mwelling/lofive/fab/lofive.xls

Qty | Reference(s) | Value | Footprint | Mfg. Part #
2 | C1, C2 | 12pF | Capacitor_SMD:C_0402_1005Metric | GRM1555C1H120JA01D
5 | C3, C4, C13, C14, C17 | 10uF | Capacitor_SMD:C_0402_1005Metric | GRM155R60G106ME44D
9 | C5, C6, C7, C8, C9, C10, C11, C12, C15 | 0.1uF | Capacitor_SMD:C_0402_1005Metric | GRM155R71C104KA88J
1 | C16 | 10nF | Capacitor_SMD:C_0402_1005Metric | GRM155R71C103KA01J
2 | G1, G2 | FIDUCIAL | lofive:Fiducial_1mm_Dia_2.00mm_Outer_CopperTop | N/A
1 | J1 | CONN_01X14 | lofive:PinHeader_1x14_P2.54mm_Vertical_Castellated_Right | 61301411121
1 | J2 | CONN_01X14 | lofive:PinHeader_1x14_P2.54mm_Vertical_Castellated_Left | 61301411121
1 | R1 | 100 | Resistor_SMD:R_0402_1005Metric | ERA-2AED101X
5 | R2, R3, R5, R6, R7 | 100K | Resistor_SMD:R_0402_1005Metric | ERA-2AED104X
1 | R4 | 150K | Resistor_SMD:R_0402_1005Metric | CPF0402B150KE1
1 | SW1 | SW_Push | Button_Switch_SMD:SW_SPST_EVQP2 | EVQ-P2202M
1 | U1 | E310-G002 | Package_DFN_QFN:UQFN-48-1EP_6x6mm_P0.4mm_EP4.45x4.45mm | FE310-G002
1 | U2 | IS25LP128-JBLE | Package_SO:SOIJ-8_5.3x5.3mm_P1.27mm | IS25LP128-JBLE
1 | U3 | SPX3819M5-L-3-3 | Package_TO_SOT_SMD:SOT-23-5 | SPX3819M5-L-3-3
1 | U4 | SPX3819M5-L-1-8 | Package_TO_SOT_SMD:SOT-23-5 | SPX3819M5-L-1-8
1 | U5 | SN74LVC1G07 | Package_TO_SOT_SMD:SOT-23-5 | SN74LVC1G07DBVR
1 | Y1 | 16MHz | Crystals_Oscillators_SMD:crystal_FA238-TSX3225 | CX2520DB16000H0FLJC1
