mwelling/lofive/lofive.pdf

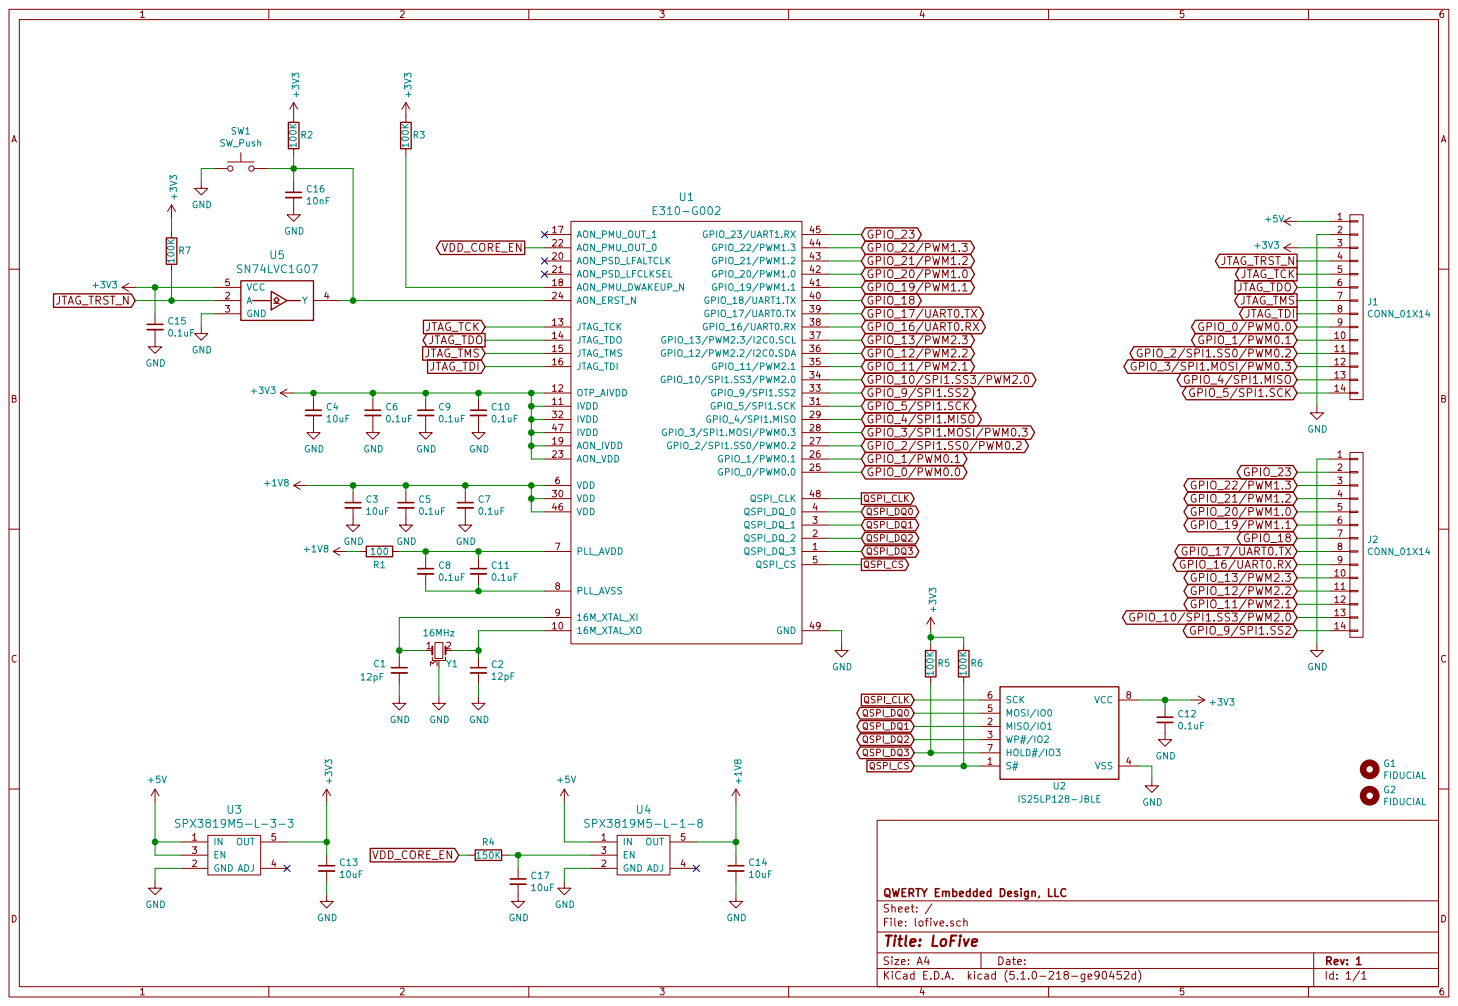
[picture p4: page 1]

File: lofive.sch Sheet: / QWERTY Embedded Design, LLC
