mwelling/lofive/(threads)

Thread 2 (2017-09-21):

Missing libraries when opening schematics

johkra, 2017-09-21:
When I open the schematics with Kicad 4.0.7, the following libraries are missing:
- e310-g000
- is25lp128
- spx3819
- graphic
- logo
- sn74lvc1g07

Could you add the libraries to the repository, please?

mwelling, 2017-09-21:
Sure, I will restructure the libraries so they are hosted within the project.

mwelling, 2017-09-21:
Pull and try it now.

johkra, 2017-09-22:
Everything opens without errors now. Thank you very much for the quick fix and for publishing the project as open hardware!

(I live in Europe and shipping for the groupgets campaign is almost twice as expensive as the board itself. :-( )

mwelling, 2017-09-22:
You are welcome.

Yes, I have heard from several countries that the shipping was too much.

You can now order the ICs from Crowd Supply if you are adventurous enough to attempt assembly. The FE310 is a .4mm QFN so I recommend using a solder paste and steel stencil. Another option would be to tin the pads (very carefully) and use a hot air rework station.

luftek, 2017-09-25:
Maybe use US address forwarding service like Shipito.

Closed 2017-09-21.

Thread 5 (2019-10-31):

Error loading programs: `Error: Target not examined yet`

gkelly, 2019-10-31:
I have a LoFive R1 and am trying to follow the instructions [for using the new SDK](https://github.com/mwelling/lofive/wiki#programming-to-lofive-r1-using-the-new-sdk).  When I get to the programming step the program upload always fails.

The following is from me trying to run:

```
make PROGRAM=lofive-boot TARGET=lofive-r1-bootloader upload
```

If I don't press the reset button first:
```
scripts/upload --elf /home/gkelly/sandbox/freedom-e-sdk/software/lofive-boot/debug/lofive-boot.elf --openocd openocd --gdb riscv64-unknown-elf-gdb --openocd-config bsp/lofive-r1-bootloader/openocd.cfg
Open On-Chip Debugger 0.10.0+dev-00823-g20804cb4d (2019-10-30-23:00)
Licensed under GNU GPL v2
For bug reports, read
        http://openocd.org/doc/doxygen/bugs.html
Info : auto-selecting first available session transport "jtag". To override use 'transport select <transport>'.
Info : ftdi: if you experience problems at higher adapter clocks, try the command "ftdi_tdo_sample_edge falling"
Info : clock speed 10000 kHz
Info : JTAG tap: riscv.cpu tap/device found: 0x20000913 (mfg: 0x489 (SiFive Inc), part: 0x0000, ver: 0x2)
Info : datacount=1 progbufsize=16
Error: unable to halt hart 0
Error:   dmcontrol=0x80000001
Error:   dmstatus =0x00030c82
Error: Fatal: Hart 0 failed to halt during examine()
Info : Listening on port 3333 for gdb connections
Error: Target not examined yet

localhost:3333: Connection timed out.
"monitor" command not supported by this target.
"monitor" command not supported by this target.
You can't do that when your target is `exec'
"monitor" command not supported by this target.
"monitor" command not supported by this target.
```

If I do press the reset button first:
```
scripts/upload --elf /home/gkelly/sandbox/freedom-e-sdk/software/lofive-boot/debug/lofive-boot.elf --openocd openocd --gdb riscv64-unknown-elf-gdb --openocd-config bsp/lofive-r1-bootloader/openocd.cfg
Open On-Chip Debugger 0.10.0+dev-00823-g20804cb4d (2019-10-30-23:00)
Licensed under GNU GPL v2
For bug reports, read
        http://openocd.org/doc/doxygen/bugs.html
Info : auto-selecting first available session transport "jtag". To override use 'transport select <transport>'.
Info : ftdi: if you experience problems at higher adapter clocks, try the command "ftdi_tdo_sample_edge falling"
Info : clock speed 10000 kHz
Info : JTAG tap: riscv.cpu tap/device found: 0x20000913 (mfg: 0x489 (SiFive Inc), part: 0x0000, ver: 0x2)
Info : Listening on port 3333 for gdb connections
Error: Target not examined yet

localhost:3333: Connection timed out.
"monitor" command not supported by this target.
"monitor" command not supported by this target.
You can't do that when your target is `exec'
"monitor" command not supported by this target.
"monitor" command not supported by this target.
```

Here's the openocd invocation when run with `-d`: [logs](https://gist.githubusercontent.com/gkelly/0873fc39fdeccd2510be879fc60cd0e2/raw/4b53f51ea8bbb28d3f0ab6d15e4f647b3010e7bf/gistfile1.txt)

This seems to point to `riscv013_halt_go(): unable to halt hart 0`.  Unclear why it can't halt the HART.  I tried both with the riscv-openocd from the sifive site and built from the riscv-openocd github repo.

Any debugging hints?

mwelling, 2019-10-31:
Looks like there is an open issue with riscv-openocd.
https://github.com/riscv/riscv-openocd/issues/195

Has this board programmed successfully in the past?

In the past, I was able to get fresh boards to program by manually pressing the reset just before running the openocd command but it took a few tries some times.

riktw, 2019-11-02:
I have the exact same problem, I ordered two boards from Digi-Key and really wanted to work with them the weekend, but if I cannot load a program that is going to be quite difficult.

I am using the following versions:
Open On-Chip Debugger 0.10.0+dev-00822-g0409bf9b2 (2019-10-18-23:08)
GNU gdb (SiFive GDB 8.3.0-2019.08.0) 8.3

Both the latest from the SiFive website.

Pressing reset just before running the openocd command did not help.

gkelly, 2019-11-02:
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

Mine is also from Digi-Key. @mwelling which versions of the toolchain bundles are you using?

gkelly, 2019-11-02:
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

Sorry, forgot to respond to this part.  No, this is my first time trying to program this board.

> In the past, I was able to get fresh boards to program by manually pressing the reset just before running the openocd command but it took a few tries some times.

I was trying that too, thinking that maybe I needed to catch it before it had changed the pinmux to take JTAG off of the pins.  That's how I ended up with the two different behaviors in my original issue post.

mwelling, 2019-11-04:
I will have to find a fresh LoFive to see if I can replicate and fix this issue.

mwelling, 2019-11-22:
So I have been able to replicate this issue on the LoFive R1 with a fresh module.

I think I originally programmed the ones I had here with the old SDK so that is why I never ran into this issue when updating the bootloader to the new one.

Once the board has a program installed on the flash it works just fine.

Let me dig into OpenOCD and see if I can fix this.

mwelling, 2019-11-24:
@gkelly What distribution / version of Linux are you using?

I found that the prebuilt Ubuntu toolchain was causing the issue on my computer. I am using Debian 10 and it does not have libncurses5 by default and the gdb instance was failing to launch.

```
make PROGRAM=lofive-boot TARGET=lofive-r1-bootloader upload
scripts/upload --elf /home/michael/projects/freedom-e-sdk/software/lofive-boot/debug/lofive-boot.elf --openocd /home/michael/toolchains/riscv-openocd-0.10.0-2019.08.2-x86_64-linux-ubuntu14/bin/openocd --gdb /home/michael/toolchains/riscv64-unknown-elf-gcc-8.3.0-2019.08.0-x86_64-linux-ubuntu14/bin/riscv64-unknown-elf-gdb --openocd-config bsp/lofive-r1-bootloader/openocd.cfg
/home/michael/toolchains/riscv64-unknown-elf-gcc-8.3.0-2019.08.0-x86_64-linux-ubuntu14/bin/riscv64-unknown-elf-gdb: error while loading shared libraries: libncurses.so.5: cannot open shared object file: No such file or directory
make: *** [Makefile:343: upload] Error 127
```

Once I installed the legacy libncurses5, I was able to program the board.

mwelling, 2019-11-24:
Maybe that was a fluke. I went back and erased the flash and now it won't program again.

mwelling, 2019-11-24:
Okay try pulling the latest changes on the lofive-r1 branch of the mwelling/freedom-e-sdk.
https://github.com/mwelling/freedom-e-sdk/commit/015f64ab090a2205002408aa6065b359651b76e7

See if that fixes the issue for you. If it doesn't work the first time, press the reset button and try again.

If you still can't get it to work send me the debugging output from openocd.

riktw, 2019-12-01:
Here is my log, still some issues:
https://pastebin.com/ve7qyj1H

What version of OpenOCD are you using?

mwelling, 2019-12-01:
I am using the latest version provided on the SiFive website.

https://static.dev.sifive.com/dev-tools/riscv-openocd-0.10.0-2019.08.2-x86_64-linux-ubuntu14.tar.gz

mwelling, 2019-12-01:
Provide the output of the console from the launching of the programming command.

I want to make sure that the gdb instance is running as well.

riktw, 2019-12-02:
Ah sorry, the previous log was OpenOCD only. I now added the -d flag to the upload script so I can use the "make PROGRAM=lofive-boot TARGET=lofive-r1-bootloader upload" command and get a complete log with OpenOCD and GDB:
https://pastebin.com/gJahf10H

mwelling, 2019-12-02:
Does pressing the reset button before starting the upload help?

riktw, 2019-12-02:
The result remains the same. I tried a few times, pressing the reset button just before, during or a few seconds before upload..

mwelling, 2019-12-02:
Can you try with the prebuilt versions of openocd and the toolchain provided here so we can make sure that we have the same setup?

https://www.sifive.com/boards

See "Prebuilt RISC‑V / GCC Toolchain and Emulator" section.

riktw, 2019-12-15:
I am already using the latest binaries from there.
I am going to see if I can find a J-Link somewhere, as the Hifive board with the G002 chip uses an on board J-Link. Perhaps that helps getting these programmed.

mwelling, 2019-12-15:
Yeah JLink supports this SoC as well. Sorry this is being so difficult.

https://wiki.segger.com/GroupGets_LoFive_R1_1

psherman42, 2024-11-26:
The dreaded messages
`Error: unable to halt hart 0`
`Error: Fatal: Hart 0 failed to halt during examine()`
and
`Error: Target not examined yet`
have to do with a subtle difference between the HiFive and the LoFive boards: With the latter, input bias current on the EN input of the 1.8v regulator is too high, not allowing sufficient time for a solid reset.

Pushbutton SW1 (and JTAG TRST) trigger the AON_ERST_N non-maskable interrupt input.

Default programming in the Mask ROM for the PMUWAKEUP state machine provides moderate 16-cycle delay, and thus pulse width, for the AON_PMU_OUT_0 output.

RC combination of 150K Ohms and 10 uF (R4, C17 on LoFive; R32, C22 on HiFive) attempt to provide ~670 mS delay for the reset pulse.

However, this is where the problem lies: HiFive U8 is a RT9080-18GJ5 device whose EN input bias current is less than 0.1 uA. LoFive U4 is an SPX3819M5-L-1-8 device whose EN input bias current is around 3 uA and can be as high as 20 uA.

In other words, on the LoFive board, regardless how long the pushbutton SW1 (or JTAG TRST) is held, the output pulse from the PMU of the AON block simply never makes it down to low enough level to momentarily turn OFF the 1.8v supply -- thus, the CPU never resets.

The only recourse is complete removal of the 5V power for a brief moment. Either reducing the RC time constant (lowering values of R4 and/or C17) or selecting a 1.8v regulator with lower input bias current is suggested.

Thread 7 (2020-04-21):

Checkout freedom-metal to another branch

m3x1m0m, 2020-04-21:
Just tried out to get a newer version of freedom-metal running. I switched to the master branch in the freedom-metal submodule.

Compilation works, but it cannot find the correct library file (apparently). I am sure this is possible. I did not find any documentation on that subject.

```
cp /home/tux/freedom-e-sdk/bsp/lofive-r1/install/lib/debug/libriscv__mmachine__lofive-r1.a /home/tux/freedom-e-sdk/bsp/lofive-r1/install/lib/debug/libmetal.a
cp: cannot stat '/home/tux/freedom-e-sdk/bsp/lofive-r1/install/lib/debug/libriscv__mmachine__lofive-r1.a': No such file or directory
make: *** [scripts/libmetal.mk:88: /home/tux/freedom-e-sdk/bsp/lofive-r1/install/lib/debug/libmetal.a] Error 1
```

mwelling, 2020-04-21:
In the BSP directory there is an update-targets.sh script that may need to be run.

I have not looked at the recent updates on the freedom SDK so I would have to perform the updates to try and replicate.

What are the exact steps that you performed?

m3x1m0m, 2020-04-22:
Thanks for the comment.

```
cd freedom-metal
git checkout master
cd ..
make PROGRAM=sifive-welcome TARGET=lofive-r1 software
```
This is what I have done before. I also ran

`bash update-targets.sh`

as you suggested and ...

```
update-targets.sh: line 107: dtc: command not found
update-targets.sh: Failed to compile freedom-e310-arty//design.dts to dtb
...
```
Seems like my toolchain is not setup correctly.

mwelling, 2020-04-22:
You will need the devicetree compiler. Also notice that even the mainline freedom-e-sdk doesn't use the master branch.

Maybe it is about time to attempt merging lofive to the upstream repository.

Layke, 2021-12-04:
Plus one for merging the lofive to the upstream repository. I'm currently trying to program my first LoFive board and running into issues. Would love to contribute as I do this.

mwelling, 2021-12-07:
@Layke heads up!

When SiFive switched silicon revision they depracated openocd support.

It works but only after the very first programming of the flash.
If you are one of the unlucky people that didn't get the flash programmed this will effect you

Switching to JLINK is the easy way out:
https://github.com/mwelling/lofive/issues/5#issuecomment-565856885

I have not updated the SDK in years so maybe they fixed it by now but I doubt it.

Contributions are always welcome so if you get something working, document it
and upstream where possible.

For collaboration I have a channel on discord:
https://discord.gg/n6CnKFFg

hubbsvtgc, 2022-04-18:
@mwelling  I just got couple of lofive boards today. would like to know if the FE310-G002 in the lofive has the same init code in OTP and jumps into flash as it happens in Hifive1-rev B board? What is the best way to quickly bringup the board with gdb & load the code into ram and execute? I assume the openocd script that works on hifive1-revb Board should work for this as well.

Thread 8 (2020-04-26):

JTag question

quantrpeter, 2020-04-26:
Hi All
   Where i can find information about:
1. using JTag to set the breakpoint in memory and trap the cpu, then single-step running in assembly level?
2. what jtag i can use to work with this board and where i can buy it?
thanks
Peter

mwelling, 2020-04-27:
The programming method listed here uses JTAG to program the device:
https://github.com/mwelling/lofive/wiki

The segger JLink is also supported:
https://wiki.segger.com/GroupGets_LoFive_R1_1

Either should allow for the use of GDB for debugging.

mwelling, 2020-04-27:
There is freedom studio that provides a eclipse based graphical IDE if you are interested.

https://www.sifive.com/boards/

I have never tried but let me know if you need help setting it up.

Closed 2020-10-31.

Thread 10 (2021-11-08):

Cannot Open PCB Veiw in KiCad Project

Tauheed-Elahee, 2021-11-08:
I cannot open the PCB view of the KiCad Project. I am using KiCad 5.1.10, released May 2021. The error says to use KiCad version with a date of 2019-03-11 or newer.

I am running Debian GNU/Linux testing/sid. I am using the flatpak version of the application. The problem also occurs on Windows.

Here is the error I get.
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

mwelling, 2021-11-08:
Unfortunately it is not easily possible to revert a design back to an older version of Kicad.

Can you try with the nightly build and see if it opens with that?
https://www.kicad.org/download/debian/
https://downloads.kicad.org/kicad/windows/explore/nightlies

Tauheed-Elahee, 2021-11-09:
I am using KiCad 5.1.10, it was released May of 2021 (this year). This is the *latest stable* release of *2021*. The error asks for a version that is from *2019 or later*.

There are no nightly builds for debian.
> There might sometimes some pre versions of upcoming releases available in experimental. These are usually no nightly but a RC (Release Candidate) versions!

- https://downloads.kicad.org/kicad/windows/explore/nightlies

I will try with Windows.

Can you update the project so that it works with KiCad version 5.1.10 (the latest *stable* release)?

Tauheed-Elahee, 2021-11-09:
I changed to Still in Development (sid) branch on Debian and tried to use the release candidate on the repository it is version 5.1.12 the same error occurs.

mwelling, 2021-11-09:
When I last updated the design it must have been on a compiled version on my old Debian 10 box.
As you found it does not open with any of the apt install-able versions.

Looks like Ubuntu has a nightly PPA but Debian does not.

I don't want to waste time compiling nightly for Debian so lemme try windows.

mwelling, 2021-11-09:
Was able to open in 5.99 in Windows, Saving new versions. Ran DRC, fixed a new errors, and repoured the planes.

Get KiCAD 5.99 running and it should open with it now.

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

Tauheed-Elahee, 2021-11-09:
Thank you.

I was able to install `kicad-nightly` on Debian GNU/Linux. Below are resources and the way I got it installed.

- KiCad forum thread on installing kicad-nightly: [https://forum.kicad.info/t/nightly-builds-for-debian-buster-and-bullseye/27487](https://forum.kicad.info/t/nightly-builds-for-debian-buster-and-bullseye/27487)
- Debian package page for `libglew2.1` a needed dependency for `kicad-nightly`: [https://packages.debian.org/sid/libglew2.1](https://packages.debian.org/sid/libglew2.1)

Steps:
```bash
sudo echo "deb https://debian.sur5r.net/kicad-nightly bullseye main" >> /etc/apt/sources.list   #check to see if it is there. Use text editor if it is not there.

/usr/lib/apt/apt-helper download-file https://debian.sur5r.net/kicad-nightly/pool/main/s/sur5r-keyring/sur5r-keyring_2021.02.02_all.deb sur5r-keyring.deb SHA256:cccfb1dd7d6b1b6a137bb96ea5b5eef18a0a4a6df1d6c0c37832025d2edaa710

sudo dpkg -i ./sur5r-keyring.deb

# install deb package from link above
sudo dpkg -i libglew2.1_2.1.0-4+b1_amd64.deb

sudo apt update

sudo apt install kicad-nightly
```

It works now.

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

I can see why you chose to use the nightly versions. On first glance, the interface is vastly improved and looks like other professional EDA tools.

Is there a plan to move to the stable releases of KiCad once these improvements have been released into a stable release?

mwelling, 2021-11-09:
https://techexplorations.com/blog/kicad/kicad-6-review-new-and-improved-features/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,first%20major%20release%20since%202018.

Tauheed-Elahee, 2021-11-09:
Looks very promising. I can't wait for it to be released.

Until then, can you add a line in the `README.md` telling the user of the repository to use the nightly version of KiCad for now and detailing how to get it or linking to this issue?

mwelling, 2021-11-09:
Sure.

Closed 2021-11-09.

Thread 11 (2021-12-05):

Open the SDK

Layke, 2021-12-05:
In your Wiki, you mention open the SDK. What do you mean by open?

mwelling, 2021-12-05:
Sorry for not being clear. I mean open a terminal again and `cd` into the directory of the SDK.

Then you can run the `make` commands to build and program the device.

mwelling, 2021-12-05:
I updated the wiki to be more clear. Please let me know if you have any other questions.

Layke, 2021-12-05:
No worries, I'm here to help!

You say open the SDK in a new console, but that still confuses me. What am
I opening?

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

mwelling, 2021-12-06:
Opening a terminal window and cd'ing into the sdk directory.

Layke, 2021-12-07:
Thank you! Compiling the lofive tools right now. Hopefully I get this
little board up and running! Much appreciated!

On Mon, Dec 6, 2021 at 1:35 PM Michael Welling ***@***.***>
wrote:

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

Closed 2021-12-05.
