mwelling/lofive/(commit log)

2017-08-07 Initial commit of LoFive
    [lofive.kicad_pcb, lofive.sch]
2017-08-07 Add KiCAD .gitignore
2017-08-07 Add PDF plot of schematic
2017-08-14 Fix README
    Mentions the wrong board.
2017-09-04 Small tweaks to prepare for manufacturing
    [lofive.kicad_pcb, lofive.sch]
2017-09-08 Add footprint library and fabrication outputs
    [lofive-B.Cu.gbr, lofive-B.Mask.gbr, lofive-B.Paste.gbr, lofive-B.SilkS.gbr, lofive-Edge.Cuts.gbr, lofive-F.Cu.gbr, lofive-F.Mask.gbr, lofive-F.Paste.gbr]
2017-09-12 Update 3D models and renderings
    [lofive.kicad_pcb]
2017-09-12 Add some specifications for the board w/ fancy png
2017-09-21 Add schematic libraries to the local repository
2017-10-09 Fix schematic net labels
    The wrong GPIO was listed on the net labels connected to pins 41, 42, 43.
    Reported-by: Gerhard Sittig <Gerhard.Sittig@gmx.net>
    [lofive.kicad_pcb, lofive.sch]
2019-03-02 Update to newer version of KiCAD
    In preparation for new version of LoFive.
    [lofive-2019-03-01-17-13-39.sch, lofive.kicad_pcb]
2019-03-03 Update design to use the new FE310-G002
    [lofive.kicad_pcb, lofive.sch]
2019-03-23 Minor tweaks
    [lofive.kicad_pcb]
2019-03-24 Schematic and PCB updates for R1
    Adds recommend enable circuit for the 1.8V rail.
    Update footprints to align with the latest KiCAD libraries.
    Adds castellated edges for fancier prototypes.
    [lofive.kicad_pcb, lofive.sch]
2019-03-25 Gerber release LoFive R1
    All plots updated. Ready for fab.
    [lofive-B.Cu.gbr, lofive-B.Mask.gbr, lofive-B.Paste.gbr, lofive-B_Cu.gbr, lofive-B_Mask.gbr, lofive-B_Paste.gbr, lofive-B_SilkS.gbr, lofive-Edge_Cuts.gbr]
2019-04-03 Add zip of gerbers and updated BOM
    [lofive.xls]
2019-04-10 Update BOM with correct PN for buffer IC
    [lofive.xls]
2019-04-20 Update design for manufacturing release
    Adds pullups for SPI flash and reset circuit.
    [lofive-B_Cu.gbr, lofive-B_Mask.gbr, lofive-B_Paste.gbr, lofive-B_SilkS.gbr, lofive-Edge_Cuts.gbr, lofive-F_Cu.gbr, lofive-F_Mask.gbr, lofive-F_Paste.gbr]
2021-11-09 Update to KiCAD 5.99
    Ran DRC, fixed a new errors, and re-poured the planes.
    [lofive.kicad_pcb, lofive.kicad_sch]
2021-11-09 Update README to reflect switch to KiCAD 5.99
2026-02-20 Update to KICAD 9
    [lofive.kicad_pcb, lofive.kicad_sch]
2026-02-20 Update required KiCAD version to 9 or higher
